JMechW/Q-Baller-Ballbot-Project/Q-Baller Embedded System/JMechW Robotic Board PCB Design.png

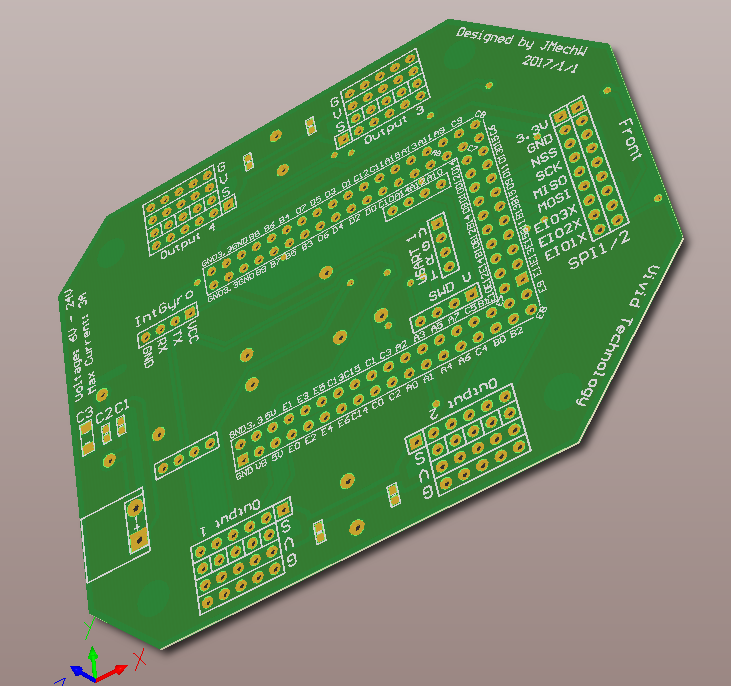
Q-Baller Embedded System/JMechW Robotic Board PCB Design.png
