JMechW/Q-Baller-Ballbot-Project/Q-Baller Design & Prototype/3D CAD Design Model.png

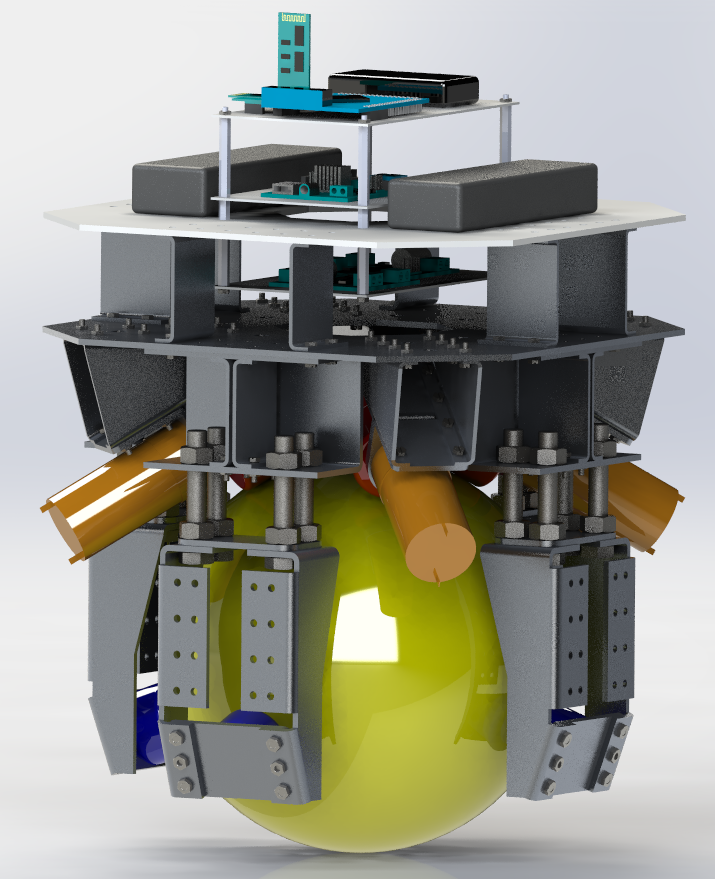
Q-Baller Design & Prototype/3D CAD Design Model.png
