JMechW/Q-Baller-Ballbot-Project/Q-Baller Design & Prototype/Prototype 2016-3.jpg

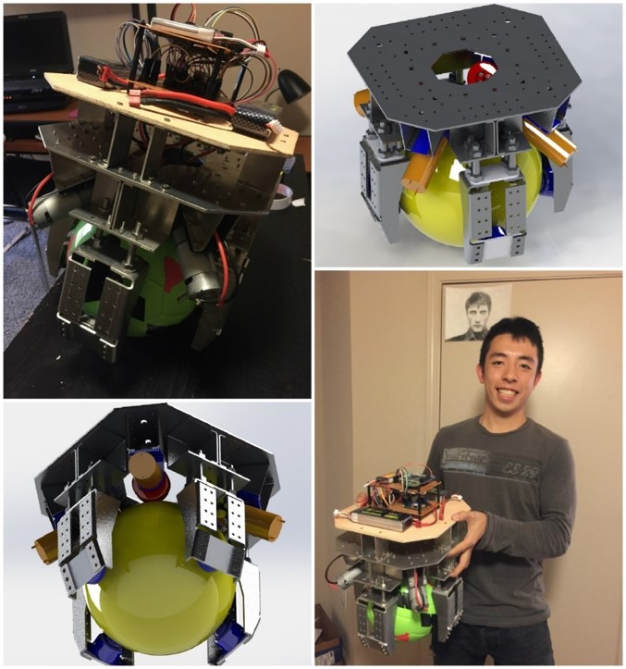
Q-Baller Design & Prototype/Prototype 2016-3.jpg
