JMechW/Q-Baller-Ballbot-Project/Q-Baller Design & Prototype/Prototype 2016-11.jpg

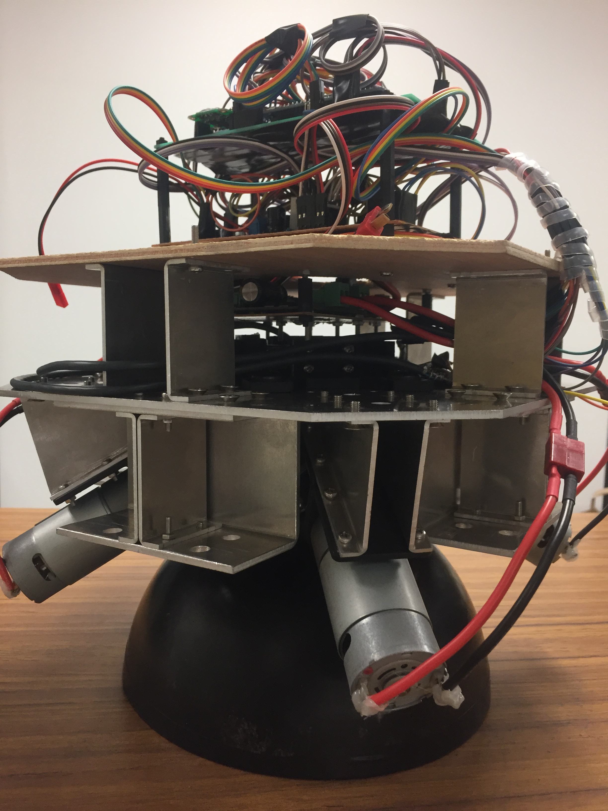
Q-Baller Design & Prototype/Prototype 2016-11.jpg
