JMechW/Q-Baller-Ballbot-Project/Q-Baller Design & Prototype/Prototype 2017-3/2017-3-4.jpg

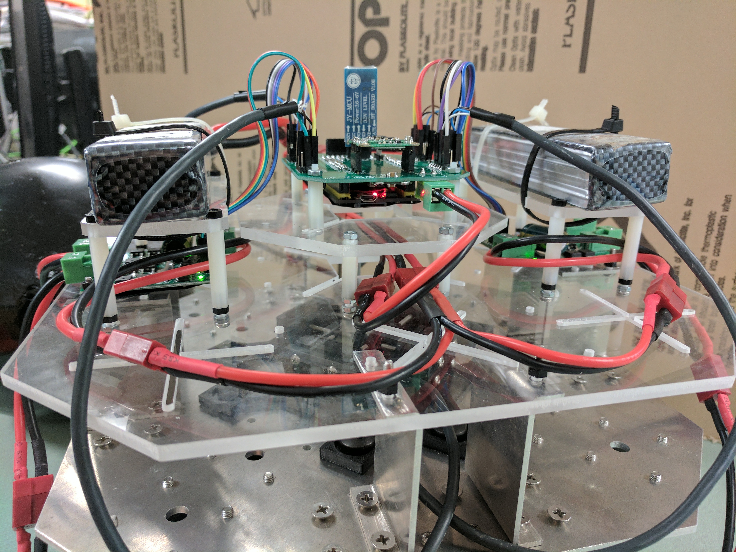
Q-Baller Design & Prototype/Prototype 2017-3/2017-3-4.jpg
