JMechW/Q-Baller-Ballbot-Project/Q-Baller Embedded System/JMechW Robotic Board - IO Plan.xlsx

Object Kind | X1 | Y1 | Name | Description | Pin Designator | Orientation | Locked
pin | -200 | 175 | GND |  | 1 | 180 Degrees | TRUE
pin | -200 | 165 | GND |  | 2 | 180 Degrees | TRUE
pin | -200 | 155 | VB |  | 3 | 180 Degrees | TRUE
pin | -200 | 145 | 3.3V |  | 4 | 180 Degrees | TRUE
pin | -200 | 135 | 5V |  | 5 | 180 Degrees | TRUE
pin | -200 | 125 | 5V |  | 6 | 180 Degrees | TRUE
pin | -200 | 115 | E0 |  | 7 | 180 Degrees | TRUE
pin | -200 | 105 | E1 |  | 8 | 180 Degrees | TRUE
pin | -200 | 95 | E2 |  | 9 | 180 Degrees | TRUE
pin | -200 | 85 | E3 |  | 10 | 180 Degrees | TRUE
pin | -200 | 75 | E4 |  | 11 | 180 Degrees | TRUE
pin | -200 | 65 | E5 (EIO5/TIM9CH1) | AF3 | 12 | 180 Degrees | TRUE
pin | -200 | 55 | E6 (EIO6/TIM9CH2) | AF3 | 13 | 180 Degrees | TRUE
pin | -200 | 45 | C13 |  | 14 | 180 Degrees | TRUE
pin | -200 | 35 | C14 (Avoid Usage) | OSC | 15 | 180 Degrees | TRUE
pin | -200 | 25 | C15 (Avoid Usage) | OSC | 16 | 180 Degrees | TRUE
pin | -200 | 15 | C0 |  | 17 | 180 Degrees | TRUE
pin | -200 | 5 | C1 |  | 18 | 180 Degrees | TRUE
pin | -200 | -5 | C2 |  | 19 | 180 Degrees | TRUE
pin | -200 | -15 | C3 |  | 20 | 180 Degrees | TRUE
pin | -200 | -25 | A0 (TIM5CH1) | AF2 | 21 | 180 Degrees | TRUE
pin | -200 | -35 | A2 (USART2) | AF7 | 22 | 180 Degrees | TRUE
pin | -200 | -45 | A1 (TIM5CH2) | AF2 | 23 | 180 Degrees | TRUE
pin | -200 | -55 | A3 (USART2) | AF7 | 24 | 180 Degrees | TRUE
pin | -200 | -65 | A4 (SPI1) | AF5 | 25 | 180 Degrees | TRUE
pin | -200 | -75 | A5 (SPI1) | AF5 | 26 | 180 Degrees | TRUE
pin | -200 | -85 | A6 (SPI1) | AF5 | 27 | 180 Degrees | TRUE
pin | -200 | -95 | A7 (SPI1) | AF5 | 28 | 180 Degrees | TRUE
pin | -200 | -105 | C4 |  | 29 | 180 Degrees | TRUE
pin | -200 | -115 | C5 |  | 30 | 180 Degrees | TRUE
pin | -200 | -125 | B0 (IO/TIM3CH3) | AF2 | 31 | 180 Degrees | TRUE
pin | -200 | -135 | B1 (IO/TIM3CH4) | AF2 | 32 | 180 Degrees | TRUE
pin | -200 | -145 | B2 |  | 33 | 180 Degrees | TRUE
pin | -200 | -155 | E7 |  | 34 | 180 Degrees | TRUE
pin | -200 | -165 | E8 |  | 35 | 180 Degrees | TRUE
pin | -200 | -175 | E9 (TIM1CH1) | AF1 | 36 | 180 Degrees | TRUE
pin | -95 | -180 | E10 |  | 37 | 270 Degrees | TRUE
pin | -85 | -180 | E11 (TIM1CH2) | AF1 | 38 | 270 Degrees | TRUE
pin | -75 | -180 | E12 |  | 39 | 270 Degrees | TRUE
pin | -65 | -180 | E13 (TIM1CH3) | AF1 | 40 | 270 Degrees | TRUE
pin | -55 | -180 | E14 (TIM1CH4) | AF1 | 41 | 270 Degrees | TRUE
pin | -45 | -180 | E15 |  | 42 | 270 Degrees | TRUE
pin | -35 | -180 | B10 (IO/TIM2CH3) | AF1 | 43 | 270 Degrees | TRUE
pin | -25 | -180 | B11 (IO/TIM2CH4) | AF1 | 44 | 270 Degrees | TRUE
pin | -15 | -180 | B12 (SPI2) | AF5 | 45 | 270 Degrees | TRUE
pin | -5 | -180 | B13 (SPI2) | AF5 | 46 | 270 Degrees | TRUE
pin | 5 | -180 | B14 (SPI2) | AF5 | 47 | 270 Degrees | TRUE
pin | 15 | -180 | B15 (SPI2) | AF5 | 48 | 270 Degrees | TRUE
pin | 25 | -180 | D8 (EIO3/USART3) | AF7 | 49 | 270 Degrees | TRUE
pin | 35 | -180 | D9 (EIO4/USART3) | AF7 | 50 | 270 Degrees | TRUE
pin | 45 | -180 | D10 |  | 51 | 270 Degrees | TRUE
pin | 55 | -180 | D11 |  | 52 | 270 Degrees | TRUE
pin | 65 | -180 | D12 (TIM4CH1) | AF2 | 53 | 270 Degrees | TRUE
pin | 75 | -180 | D13 (TIM4CH2) | AF2 | 54 | 270 Degrees | TRUE
pin | 85 | -180 | D14 (IO/TIM4CH3) | AF2 | 55 | 270 Degrees | TRUE
pin | 95 | -180 | D15 (IO/TIM4CH4) | AF2 | 56 | 270 Degrees | TRUE
pin | 200 | 175 | GND |  | 57 | 0 Degrees | TRUE
pin | 200 | 165 | GND |  | 58 | 0 Degrees | TRUE
pin | 200 | 155 | 3.3V |  | 59 | 0 Degrees | TRUE
pin | 200 | 145 | 3.3V |  | 60 | 0 Degrees | TRUE
pin | 200 | 135 | GND |  | 61 | 0 Degrees | TRUE
pin | 200 | 125 | GND |  | 62 | 0 Degrees | TRUE
pin | 200 | 115 | B9 (EIO1/I2C1/CAN1) | AF4/AF9 | 63 | 0 Degrees | TRUE
pin | 200 | 105 | B8 (EIO2/I2C1/CAN1) | AF4/AF9 | 64 | 0 Degrees | TRUE
pin | 200 | 95 | B7 (Avoid Usage) | EEPROM | 65 | 0 Degrees | TRUE
pin | 200 | 85 | B6 (Avoid Usage) | EEPROM | 66 | 0 Degrees | TRUE
pin | 200 | 75 | B5 (TIM3CH2) | AF2 | 67 | 0 Degrees | TRUE
pin | 200 | 65 | B4 (TIM3CH1) | AF2 | 68 | 0 Degrees | TRUE
pin | 200 | 55 | B3 (TIM2CH2) | AF1 | 69 | 0 Degrees | TRUE
pin | 200 | 45 | D7 |  | 70 | 0 Degrees | TRUE
pin | 200 | 35 | D6 |  | 71 | 0 Degrees | TRUE
pin | 200 | 25 | D5 |  | 72 | 0 Degrees | TRUE
pin | 200 | 15 | D4 |  | 73 | 0 Degrees | TRUE
pin | 200 | 5 | D3 |  | 74 | 0 Degrees | TRUE
pin | 200 | -5 | D2 (Avoid Usage) | SD Card | 75 | 0 Degrees | TRUE
pin | 200 | -15 | D1 |  | 76 | 0 Degrees | TRUE
pin | 200 | -25 | D0 |  | 77 | 0 Degrees | TRUE
pin | 200 | -35 | C12 (Avoid Usage) | SD Card | 78 | 0 Degrees | TRUE
pin | 200 | -45 | C10 (Avoid Usage) | SD Card | 79 | 0 Degrees | TRUE
pin | 200 | -55 | C11 (Avoid Usage) | SD Card | 80 | 0 Degrees | TRUE
pin | 200 | -65 | A14 (Avoid Usage) | SWD | 81 | 0 Degrees | TRUE
pin | 200 | -75 | A15 (TIM2CH1) | AF1 | 82 | 0 Degrees | TRUE
pin | 200 | -85 | A12 (Avoid Usage) | USB | 83 | 0 Degrees | TRUE
pin | 200 | -95 | A13 (Avoid Usage) | SWD | 84 | 0 Degrees | TRUE
pin | 200 | -105 | A10 (USART1) | AF7 | 85 | 0 Degrees | TRUE
pin | 200 | -115 | A11 (Avoid Usage) | USB | 86 | 0 Degrees | TRUE
pin | 200 | -125 | A8 (Avoid Usage) | SD Card | 87 | 0 Degrees | TRUE
pin | 200 | -135 | A9 (USART1) | AF7 | 88 | 0 Degrees | TRUE
pin | 200 | -145 | C7 (IO/TIM8CH2) | AF3 | 89 | 0 Degrees | TRUE
pin | 200 | -155 | C9 (Avoid Usage) | SD Card | 90 | 0 Degrees | TRUE
pin | 200 | -165 | C6 (IO/TIM8CH1) | AF3 | 91 | 0 Degrees | TRUE
pin | 200 | -175 | C8 (Avoid Usage) | SD Card | 92 | 0 Degrees | TRUE
pin | -15 | 180 | 3.3V | Jtag Line | 93 | 90 Degrees | TRUE
pin | -5 | 180 | SWDIO | Jtag Line | 94 | 90 Degrees | TRUE
pin | 5 | 180 | SWCLK | Jtag Line | 95 | 90 Degrees | TRUE
pin | 15 | 180 | GND | Jtag Line | 96 | 90 Degrees | TRUE
