JMechW/Q-Baller-Ballbot-Project/Q-Baller Embedded System/JMechW Robotic Board - Schematic.pdf

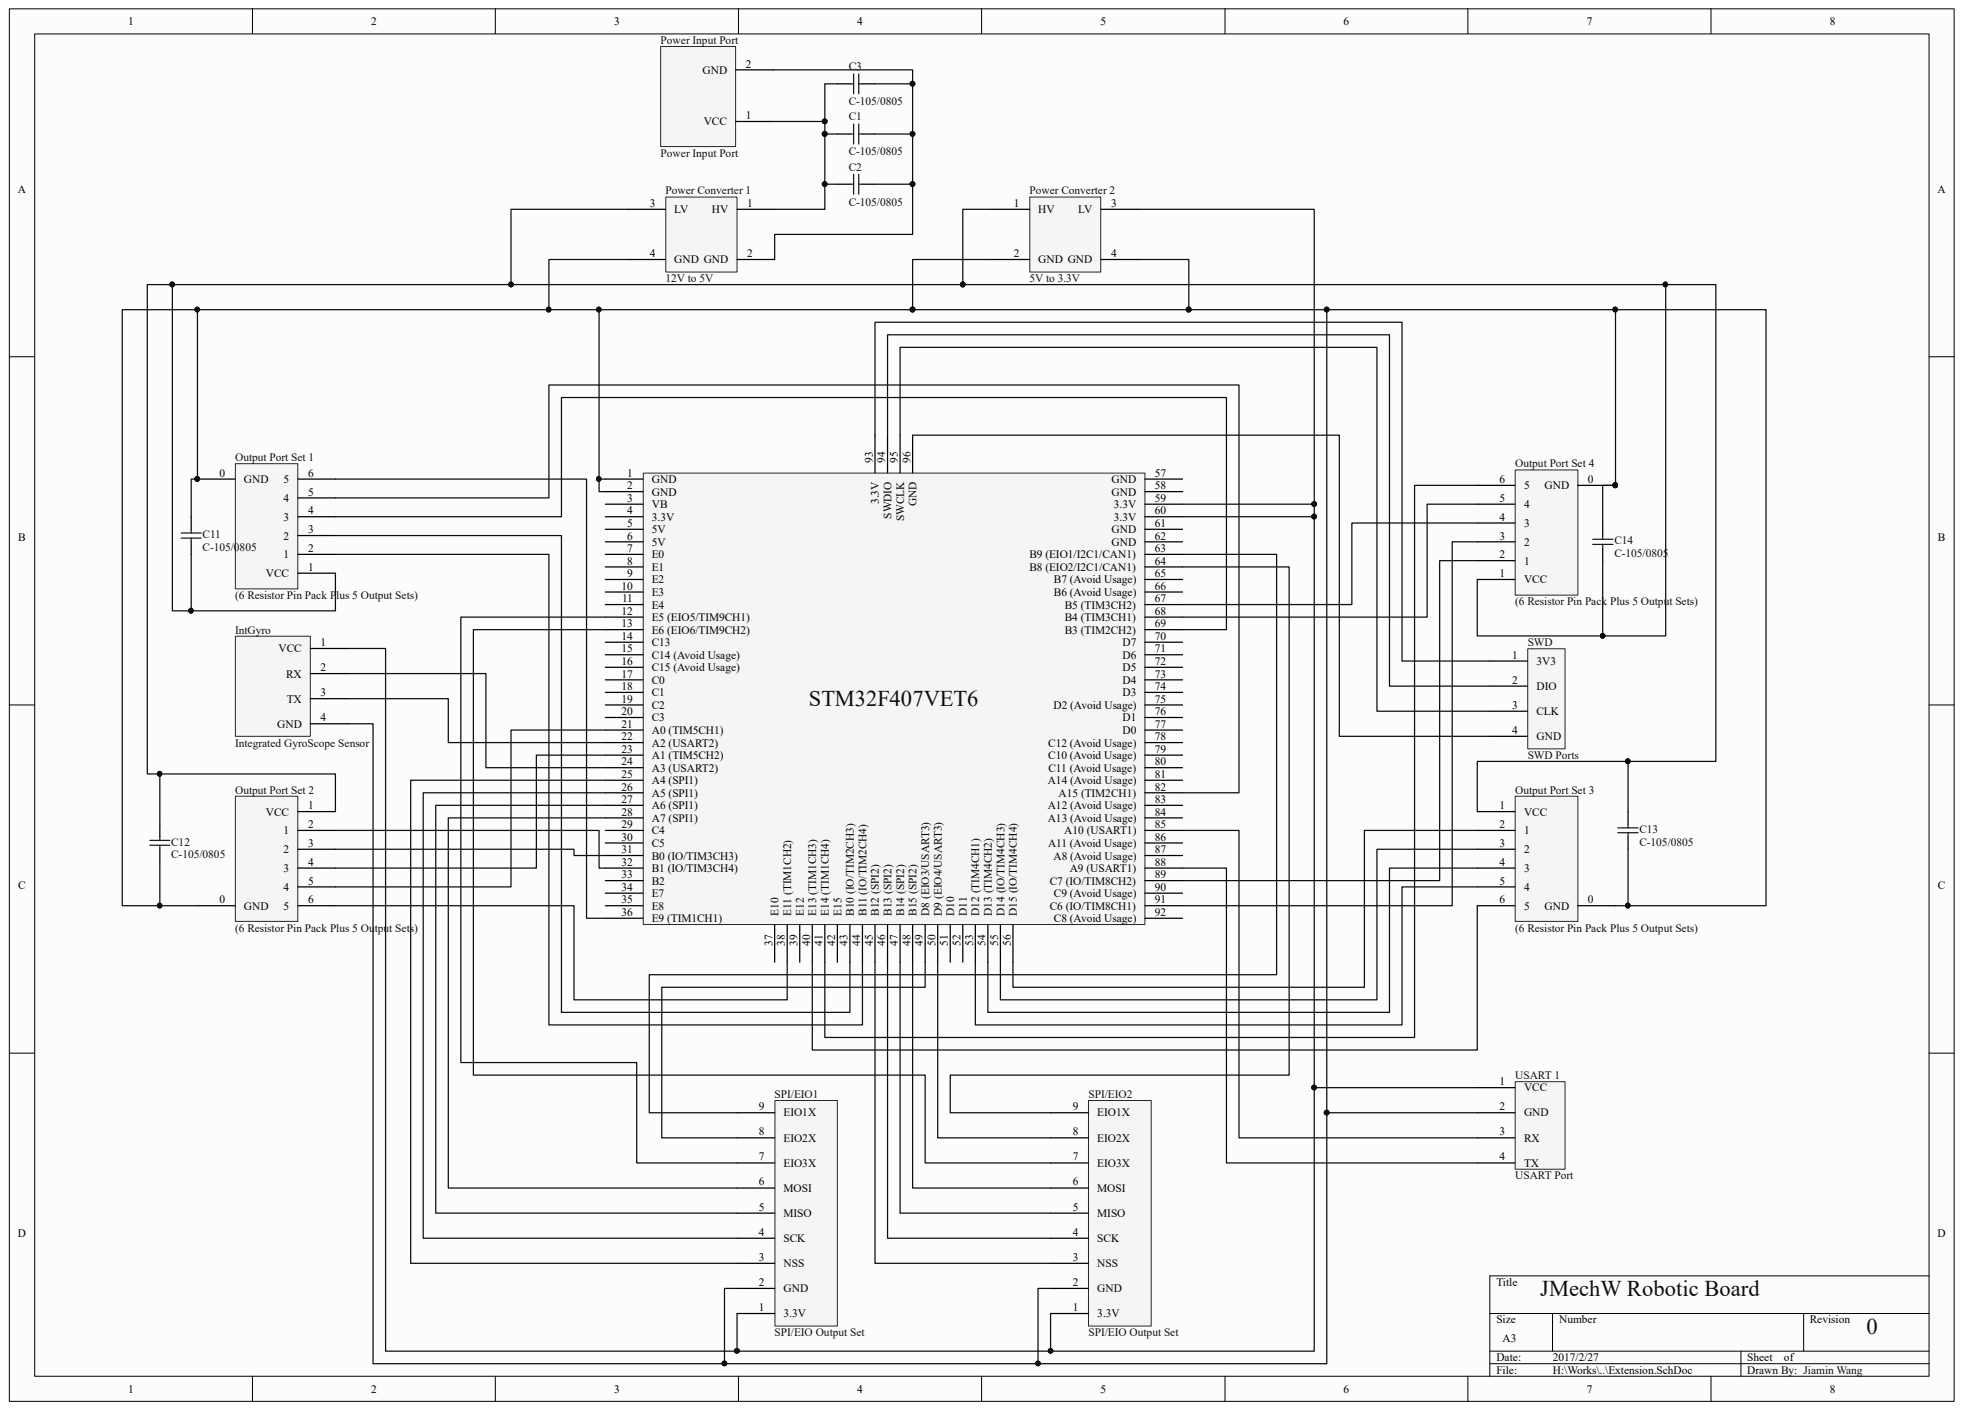
[picture p9: page 1]

(6 Resistor Pin Pack Plus 5 Output Sets)

SPI/EIO Output Set
