JMechW/Q-Baller-Ballbot-Project/Q-Baller Embedded System/Project/InControl.h

#ifndef __INCONTROL_H

#define __INCONTROL_H

#include "ProjectVariable.h"

void _Func_AB_Reference(void);
void _Func_C_Reference(void);
void _Func_XY_Reference(void);
void _Func_Reference_Update(void);
void _Func_Output_Update(void);
void _Func_InControl(void);

#endif
