JMechW/Q-Baller-Ballbot-Project/Q-Baller Embedded System/Project/PostControl.h

#ifndef __POSTCONTROL_H

#define __POSTCONTROL_H

#include "ProjectVariable.h"

void _Func_Output_RateLimit(void);
void _Func_Output_MaxLimit(void);
void _Func_Output_Deviation(void);
void _Func_OutputLimiter(void);

void _Func_PostControl(void);

#endif
