JMechW/Q-Baller-Ballbot-Project/Q-Baller Embedded System/Data/DATA.c

#include "DATA.h" //data contains most of the intermediates used for the programming, while it collects the other types of variables

Sys_StorageType SData[2];
u32 SData_Cnt[2];		//Count the Data used
