JMechW/Q-Baller-Ballbot-Project/Q-Baller Embedded System/Project/PROJECT.h

#ifndef __PROJECT_H
#define __PROJECT_H

#include "ProjectVariable.h"
#include "Function.h"
#include "Initialization.h"
#include "PreControl.h"
#include "InControl.h"
#include "PostControl.h"


#endif
