JMechW/Q-Baller-Ballbot-Project/Q-Baller Embedded System/Project/Function.h

#ifndef __FUNCTION_H
#define __FUNCTION_H

#include "ProjectVariable.h"

void _Func_Encoder_Record(void);
void _Func_Motor_Speed(void);
void _Func_Gyro_Record(void);
void _Func_Motor_Control(void);

#endif
