JMechW/Q-Baller-Ballbot-Project/(commit log)

2017-03-01 The New Ballbot Prototype Update 2017-3
    The Latest Ballbot Prototype! The spherical wheel is made from a steel spherical shell coated by rubber. Compound wood platform has been changed to plastic ones. The test boards have been replaced by the JMechW Robotic Board. The robot is in the middle of testing. Updates will be made if any conclusion can be reached by the robot.
2017-03-03 The Utility Functions Are Debugged
    These system utility algorithm (initialization & convenience purposes) for JMechW Robotic Board are debugged and can now work perfectly on the chip. The algorithm will enable you to easily initialize multiple utility setups and manage multiple system input/output at the same time.
