JMechW/Q-Baller-Ballbot-Project/(notices)

Notices in the files:
Q-Baller Embedded System/System/SYS.c:
Copyright(C) ¹ãÖÝÊÐÐÇÒíµç×Ó¿Æ¼¼ÓÐÏÞ¹«Ë¾ 2014-2024
All rights reserved
